JonnIEnglish/RotatingClimbingWall/Development of a rotary climbing wall/chaps-append/chaps-planning-details.tex

\chapter{Planning Details}

\section*{Budget Estimate}
The budget estimate below takes into account rough time and cost estimates. A more refined budget analysis will be implemented later.
Basic calculations are shown below estimating construction costs based on the retail prices of the current market competitor "Treadwall" which is priced at roughly R100 000.\\
Estimating a 3 x development cost multiplier and a 2 x material profit margin: 

\noindent
\(Total = R100,000 / (3 * 2) = R 16,666\)\\

\begin{figure}[h]
    \centering
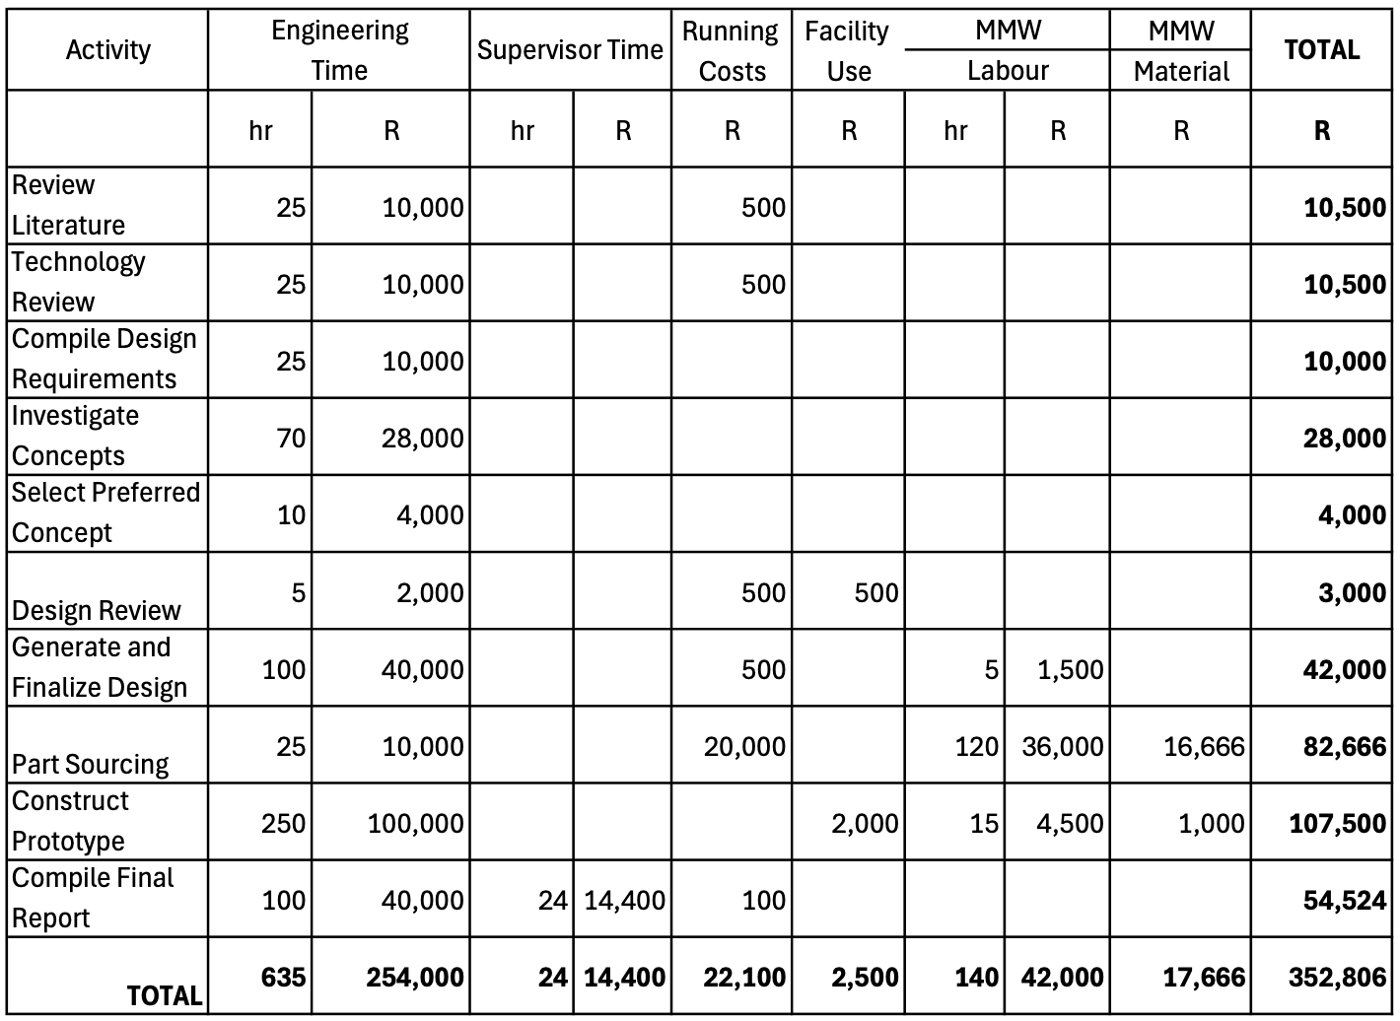
[picture p19: Development of a rotary climbing wall/chaps-append/budget.png]
    
    \caption{Estimated Project Budget}
    \label{fig:budget}
\end{figure}
\newpage

\section*{Gantt Chart}
The gant chart below outlines each planned activity and its estimated start and end date. 
\begin{figure}[htbp]
    \centering
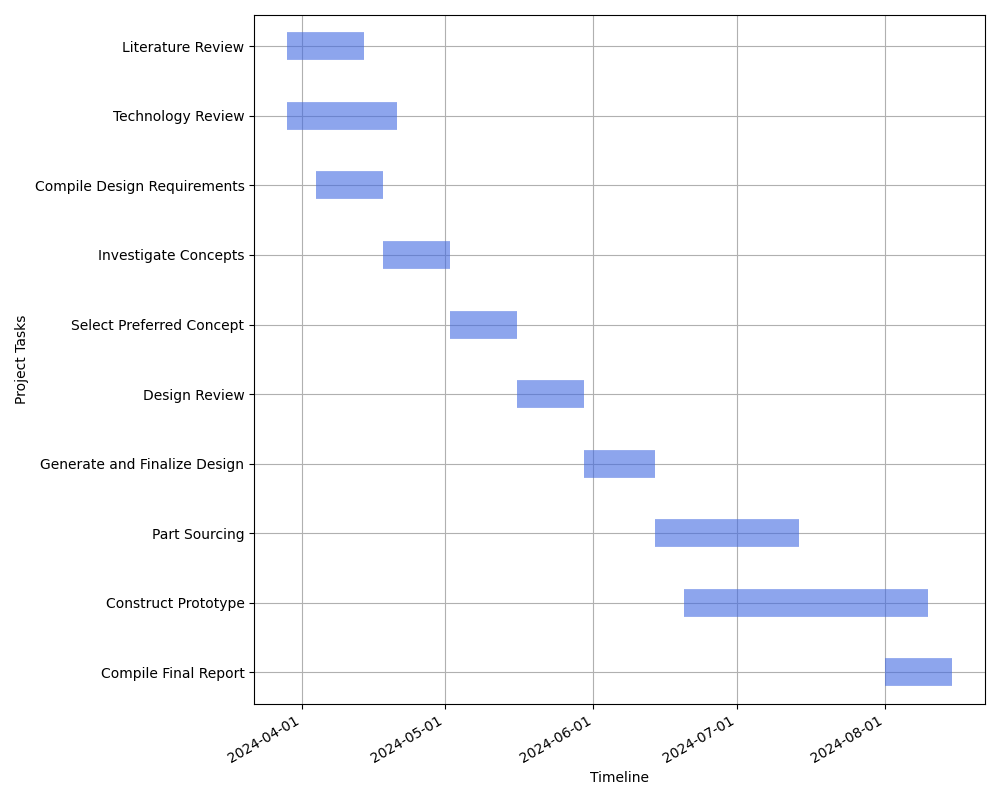
[picture p20: Development of a rotary climbing wall/chaps-append/gantt.png]
    
    \setlength{\leftskip}{-80pt} % Adjust left padding
    \caption{Gantt Chart for Rotary Climbing Wall Prototype}
    \label{fig:gantt}
\end{figure}
