JonnIEnglish/RotatingClimbingWall/Development of a rotary climbing wall/chaps-front/chap-symbols.tex

\chapter{List of symbols}
% Use stb-nomenclature + siunitx

\begin{Nomencl}[1cm]
\NomGroup{Constants}%-----------------------------------------------
    \item[$L_0 = $] \qty{300}{mm}

\NomGroup{Variables}%-----------------------------------------------
    \item[$\mathit{Re}_\mathrm{\,D}$]
                       \UnitLine{Reynolds number (diameter)}{~}
    \item[$x$]         \UnitLine{Coordinate                }{m}
    \item[$\ddot{x}$]  \UnitLine{Acceleration              }{m/s^2}\\
    
    \item[$\theta$]    \UnitLine{Rotation angle            }{rad}
    \item[$\tau$]      \UnitLine{Moment                    }{N.m}

\NomGroup{Vectors and Tensors}%-------------------------------------
    \item[$\overrightarrow{\bm{v}}$] Physical vector, see equation ...

\NomGroup{Subscripts}%----------------------------------------------
    \item[$\mathrm{a}$] Adiabatic
    \item[$a$]          Coordinate

\end{Nomencl}

\begin{Nomencl}[1cm]
\NomGroup{Abreviations}%-----------------------------------------------
    \item[DEM] Discrete Element Method
    \item[FEA] Finite Element Analysis

\end{Nomencl}
