JonnIEnglish/RotatingClimbingWall/Development of a rotary climbing wall/template-stb-report-eng.pdf

# Title

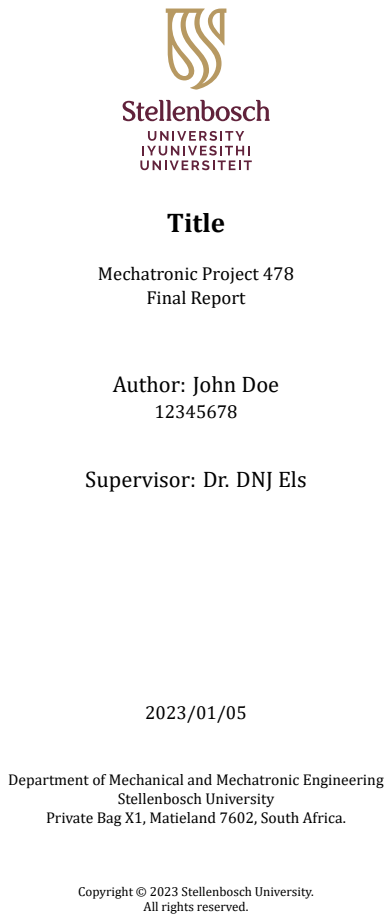
[picture p29: page 1]
Mechatronic Project 478 Final Report; Stellenbosch University

Author: John Doe

Supervisor: Dr. DNJ Els

Department of Mechanical and Mechatronic Engineering

Private Bag X1, Matieland 7602, South Africa.

Copyright © 2023 Stellenbosch University.

All rights reserved.

# Plagiarism declaration

I have read and understand the Stellenbosch University Policy on Plagiarism and the deinitions of plagiarism and self‑plagiarism contained in the Policy [Plagiarism: The use of the ideas or material of others without acknowledge‑ ment, or the re‑use of one’s own previously evaluated or published material without acknowledgement or indication thereof (self‑plagiarism or text‑recyc‑ ling)].
I also understand that direct translations are plagiarism, unless accompa‑ nied by an appropriate acknowledgement of the source. I also know that ver‑ batim copy that has not been explicitly indicated as such, is plagiarism.
I know that plagiarism is a punishable offence and may be referred to the University’s Central Disciplinary Committee (CDC) who has the authority to ex‑ pel me for such an offence.
I know that plagiarism is harmful for the academic environment and that it has a negative impact on any profession.
Accordingly all quotations and contributions from any source whatsoever (including the internet) have been cited fully (acknowledged); further, all ver‑ batim copies have been expressly indicated as such (e.g. through quotation marks) and the sources are cited fully.
I declare that, except where a source has been cited, the work contained in this assignment is my own work and that I have not previously (in its entirety or in part) submitted it for grading in this module/assignment or another mod‑ ule/assignment. I declare that have not allowed, and will not allow, anyone to use my work (in paper, graphics, electronic, verbal or any other format) with the intention of passing it off as his/her own work.
I know that a mark of zero may be awarded to assignments with plagiarism and also that no opportunity be given to submit an improved assignment.
Signature: | |
Name: | | | Student no: |
Date: | |

ii

# Executive summary

Title of Project

Objectives

What is current practice and what are its limitations? ...

What is new in this project? ...

If the project is successful, how will it make a difference?

What are the risks to the project being a success? Why is it expected to be successful?

What contributions have/will other students made/make?

Which aspects of the project will carry on after completion and why? ...

What arrangements have been/will be made to expedite continuation? ...

iii

# Acknowledgements

iv

# Table of contents

List of igures | vi
List of tables | vii
List of symbols | viii
1 Introduction | 1
2 Literature review | 2
3 Content chapter | 3
4 Conclusions | 5
A Mathematical proofs | 6
B Experimental results | 7
List of references | 8

v

# List of igures

3.1 Water plants | 4

vi

# List of tables

3.1 Standard ISO paper sizes | 4

vii

# List of symbols

Constants
L0 = 300 mm

Variables
Re D | Reynolds number (diameter) | | [ ]
x | Coordinate | | [ m ]
̈x | Acceleration | | [ m/s²
]
θ | Rotation angle | | [ rad ]
τ | Moment | | [ N·m ]

Vectors and Tensors
⃗v Physical vector, see equation ...

Subscripts
a | Adiabatic
a | Coordinate

Abreviations
DEM | Discrete Element Method
FEA | Finite Element Analysis

viii

# Chapter 1

# Introduction

## 1.1 Background

Starting from the big picture, gradually narrow focus down to this project and where this report its in.

## 1.2 Objectives

The objectives of the project (in some cases the objectives of the report). If necessary describe limitations to the scope.

## 1.3 Motivation

Why this speciic project/report is worthwhile.

1

# Chapter 2

# Literature review

## 2.1 Discrete element method

The Discrete Element Method (DEM) analysis (Cundall and Strack, 1979) uses spherical objects. Lin and Ng (1997) developed a DEM model for ellipsoids.

2

# Chapter 3

# Content chapter

Unless the chapter heading already makes it clear, an introductory paragraph that explains how this chapter contributes to the objectives of the report/project.

## 3.1 Heading level 2

### 3.1.1 Heading level 3

### 3.1.1.1 Deepest heading, only if you cannot do without it

Equations: An equation must read like part of the text. The solution of the quadratic equation ax² + bx + c = 0 given by the following expression (note the full stop after the equation to indicate the end of the sentence):

x =

−b ± √b
2 − 4ac
2b | . | (3.1)

In other cases the equation is in the middle of the sentence. Then the paragraph following the equation should start with a small letter. Euler’s identity is

e

iπ + 1 = 0, | | (3.2)

where e is Euler’s number, the base of natural logarithms.
The amsmath has a wealth of structure and information on formatting of mathematical equations.

3

4 | CHAPTER 3. CONTENT CHAPTER

Symbols and numbers: Symbols that represent values of properties should be printed in italics, but SI units and names of functions (e.g. sin, cos and tan) must not be printed in italics. There must be a small hard space between a number and its unit, e.g. 120 km. Use the siunitx package to typeset numbers, angles and quantities with units:

\num{1.23e3} | → 1.23×10³
\ang{30} | → 30°
\qty{20}{N.m} → 20 N·m

Figures and tables: The graphicx package can import PDF, PNG and JPG graphic iles.

Table 3.1: Standard ISO paper sizes

Paper | | Sizes
| W | H
| [mm] | [mm]
A0 | 841 | 1189
A1 | 594 | 841
A2 | 420 | 594
A3 | 297 | 420
A4 | 210 | 297
A5 | 148 | 210


Figure 3.1: Water plants

# Chapter 4

# Conclusions

5

# Appendix A

# Mathematical proofs

## A.1 Euler’s equation

Euler’s equation gives the relationship between the trigonometric functions and the complex exponential function.

e

iθ = cos θ + i sin θ | (A.1)

Inserting θ = π in (A.1) results in Euler’s identity

e

iπ + 1 = 0 | (A.2)

## A.2 Navier Stokes equation

The Navier–Stokes equations mathematically express momentum balance and conservation of mass for Newtonian luids. Navier‑Stokes equations using ten‑ sor notation:

∂ρ
∂t +

∂
∂xj

ρuj

= 0 | (A.3a)

∂
∂t

(ρui

) +

∂
∂xj

ρuiuj + pδij − τji = 0, i = 1, 2, 3 (A.3b)

∂
∂t

(ρe0

) +

∂
∂xj
ρuje0 + ujp + qj − uiτij = 0 | (A.3c)

6

# Appendix B

# Experimental results

7

# List of references

Cundall, P.A. and Strack, O.D.L. (1979). A discrete numerical model for granular assem‑ blies. Géotechnique, vol. 29, no. 1, pp. 47–65.

Lin, X. and Ng, T.T. (1997). A three‑dimensional discrete element model using arrays of ellipsoids. Géotechnique, vol. 47, no. 2, pp. 319–329.

8
