JonnIEnglish/RotatingClimbingWall/Development of a rotary climbing wall/figs/DesignMethodologyFlow.pdf

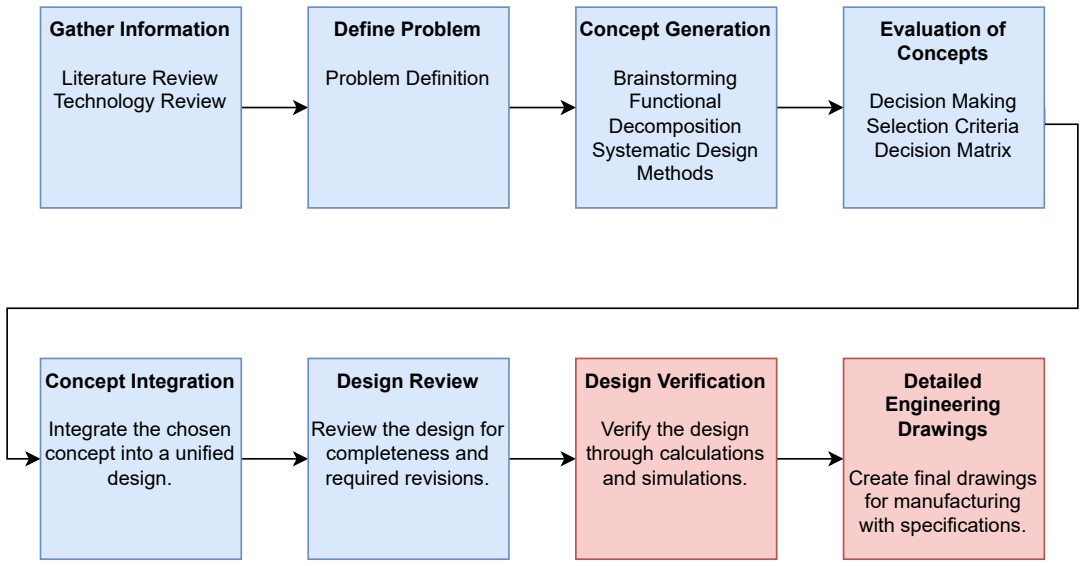
[picture p30: figure]
Gather Information; Literature Review Technology Review; Concept Generation; Brainstorming Functional Decomposition Systematic Design Methods; Evaluation of Concepts; Decision Making Selection Criteria Decision Matrix; Concept Integration; Integrate the chosen concept into a unified design.; Design Review; Review the design for completeness and required revisions.; Design Verification; Verify the design through calculations and simulations.; Detailed Engineering Drawings; Create final drawings for manufacturing with specifications.; Define Problem; Problem Definition

Conceptual
Design

Key

Detail Design
