JonnIEnglish/RotatingClimbingWall/Development of a rotary climbing wall/chaps-append/Budget_table.png

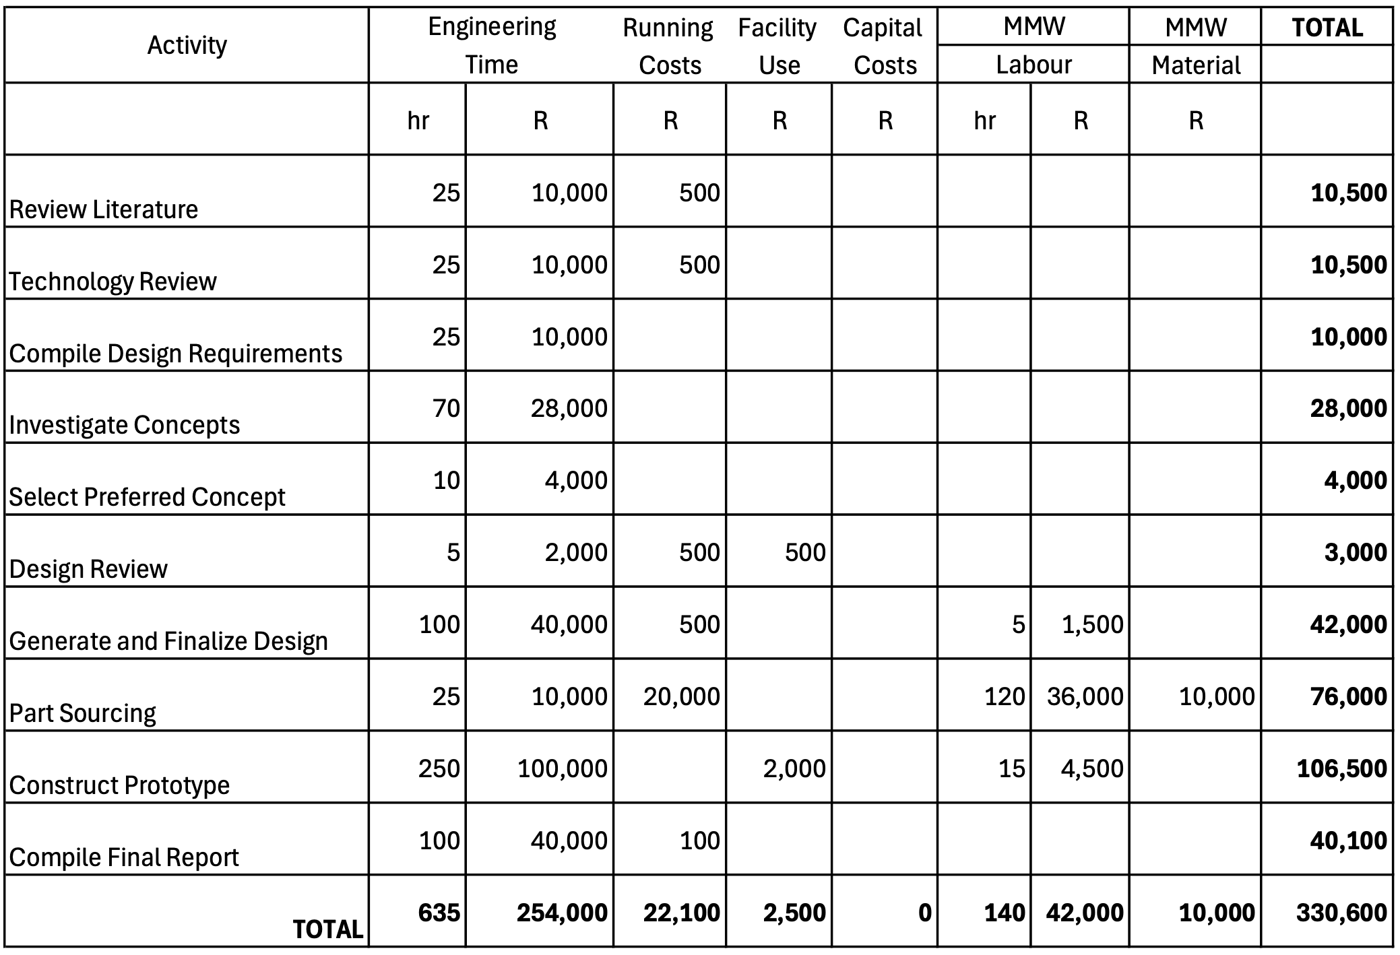
Development of a rotary climbing wall/chaps-append/Budget_table.png
