JonnIEnglish/RotatingClimbingWall/Development of a rotary climbing wall/chaps-append/calcs/tilt_torqe_calcs.png

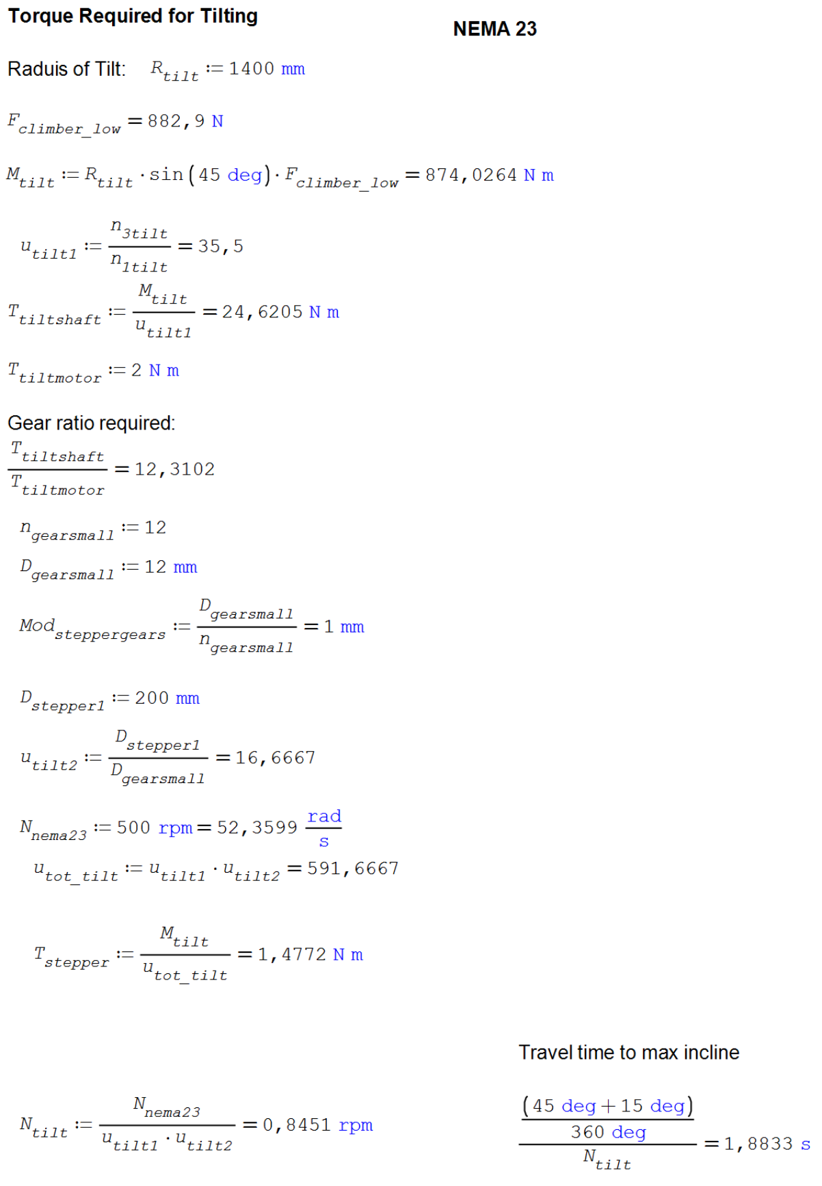
Development of a rotary climbing wall/chaps-append/calcs/tilt_torqe_calcs.png
