JonnIEnglish/RotatingClimbingWall/Development of a rotary climbing wall/chaps-append/macsteel-prices.png

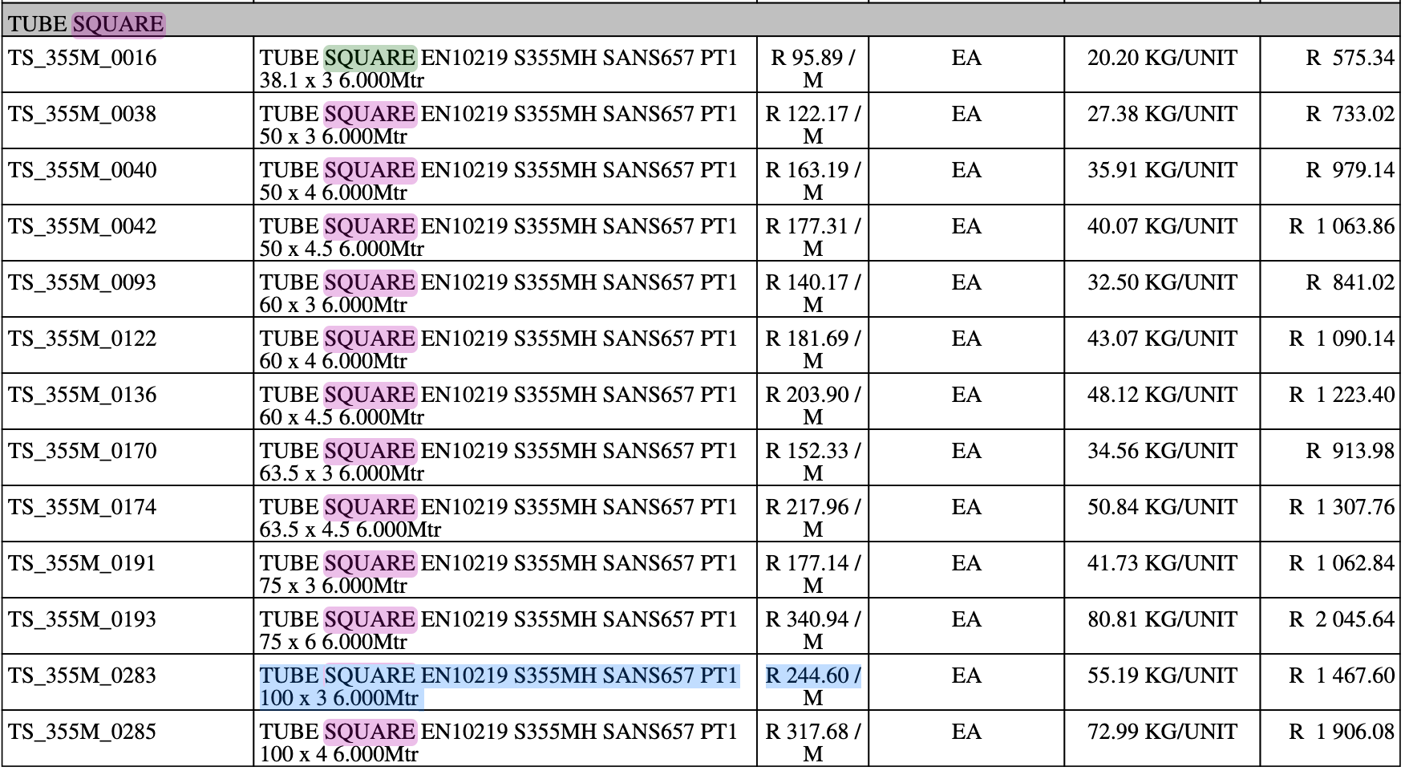
Development of a rotary climbing wall/chaps-append/macsteel-prices.png
