JonnIEnglish/RotatingClimbingWall/Development of a rotary climbing wall/figs/FEM/TiltingShaft.png

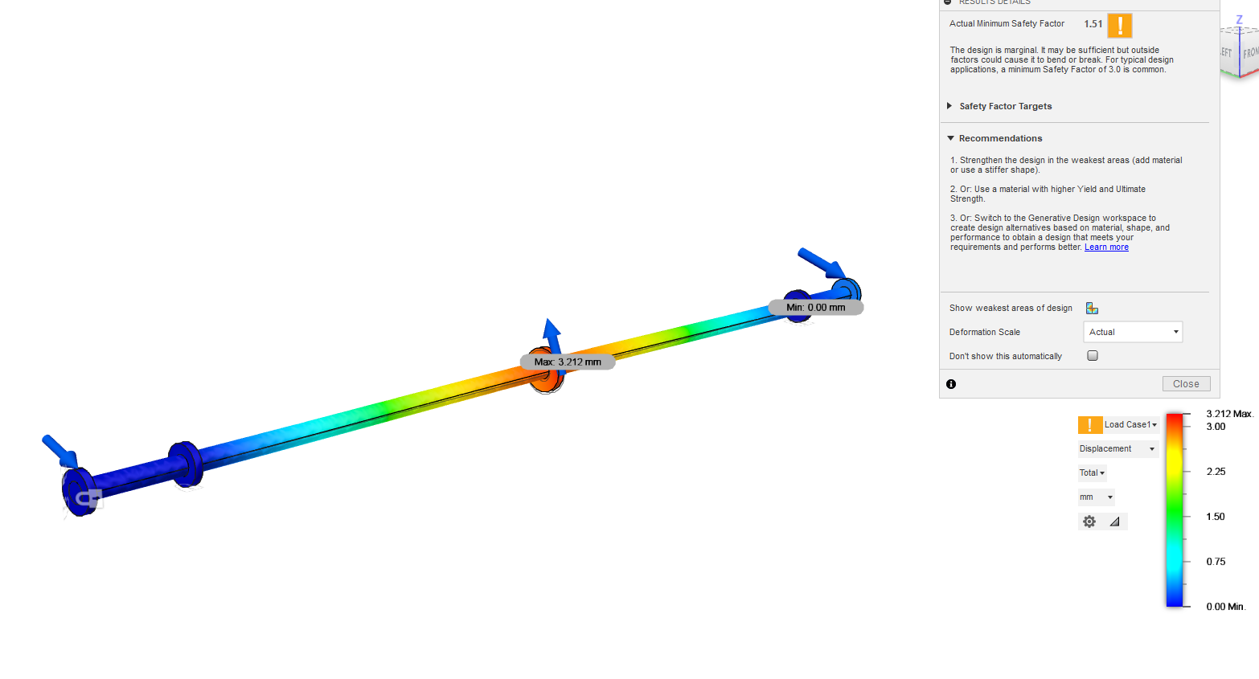
Development of a rotary climbing wall/figs/FEM/TiltingShaft.png
