JonnIEnglish/RotatingClimbingWall/Development of a rotary climbing wall/figs/final_design/FEMBracket0.png

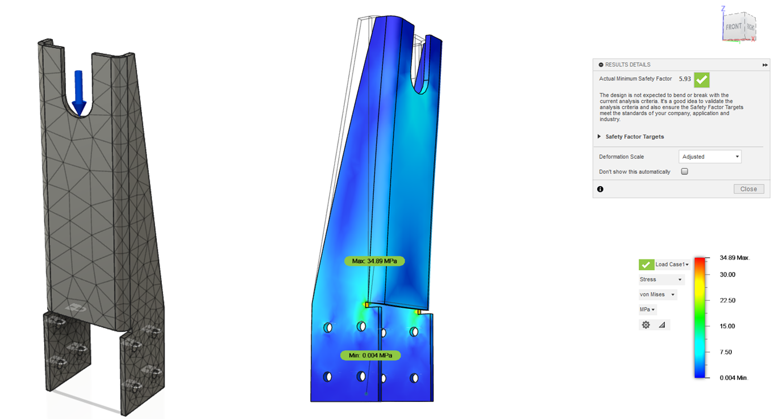
Development of a rotary climbing wall/figs/final_design/FEMBracket0.png
