JonnIEnglish/RotatingClimbingWall/Development of a rotary climbing wall/figs/training_table.png

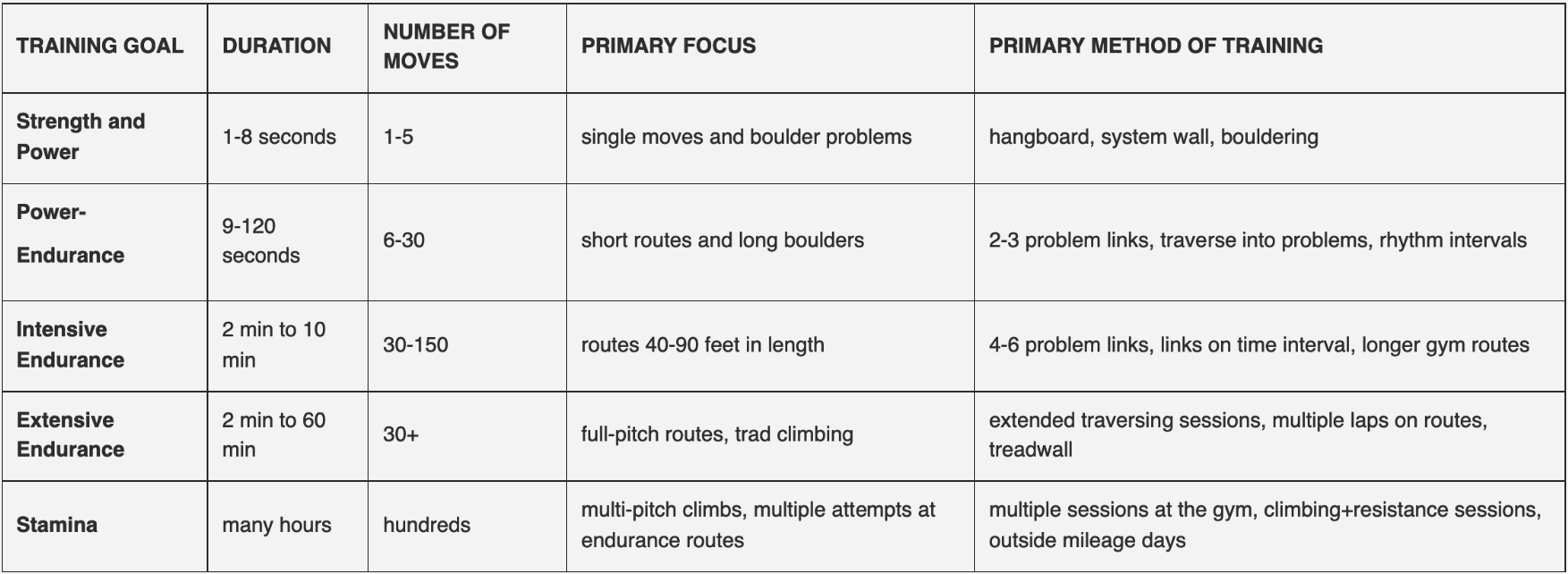
Development of a rotary climbing wall/figs/training_table.png
