JonnIEnglish/RotatingClimbingWall/Development of a rotary climbing wall/figs/treadwall.jpg

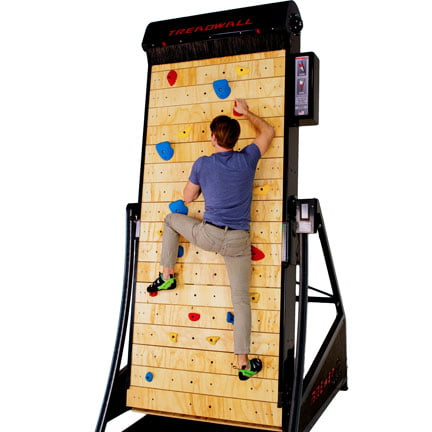
Development of a rotary climbing wall/figs/treadwall.jpg
