JonnIEnglish/RotatingClimbingWall/Development of a rotary climbing wall/figs/treadwall_kore4_CAD.png

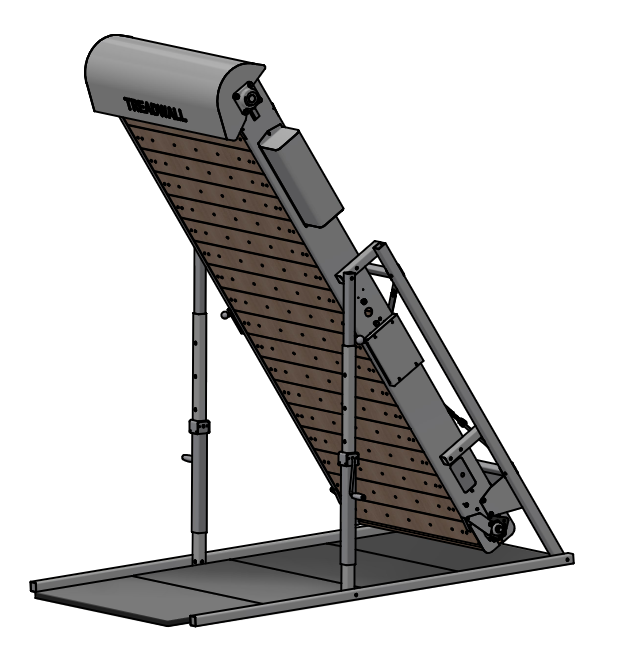
Development of a rotary climbing wall/figs/treadwall_kore4_CAD.png
