JonnIEnglish/RotatingClimbingWall/Development of a rotary climbing wall/figs/volume_intensity.png

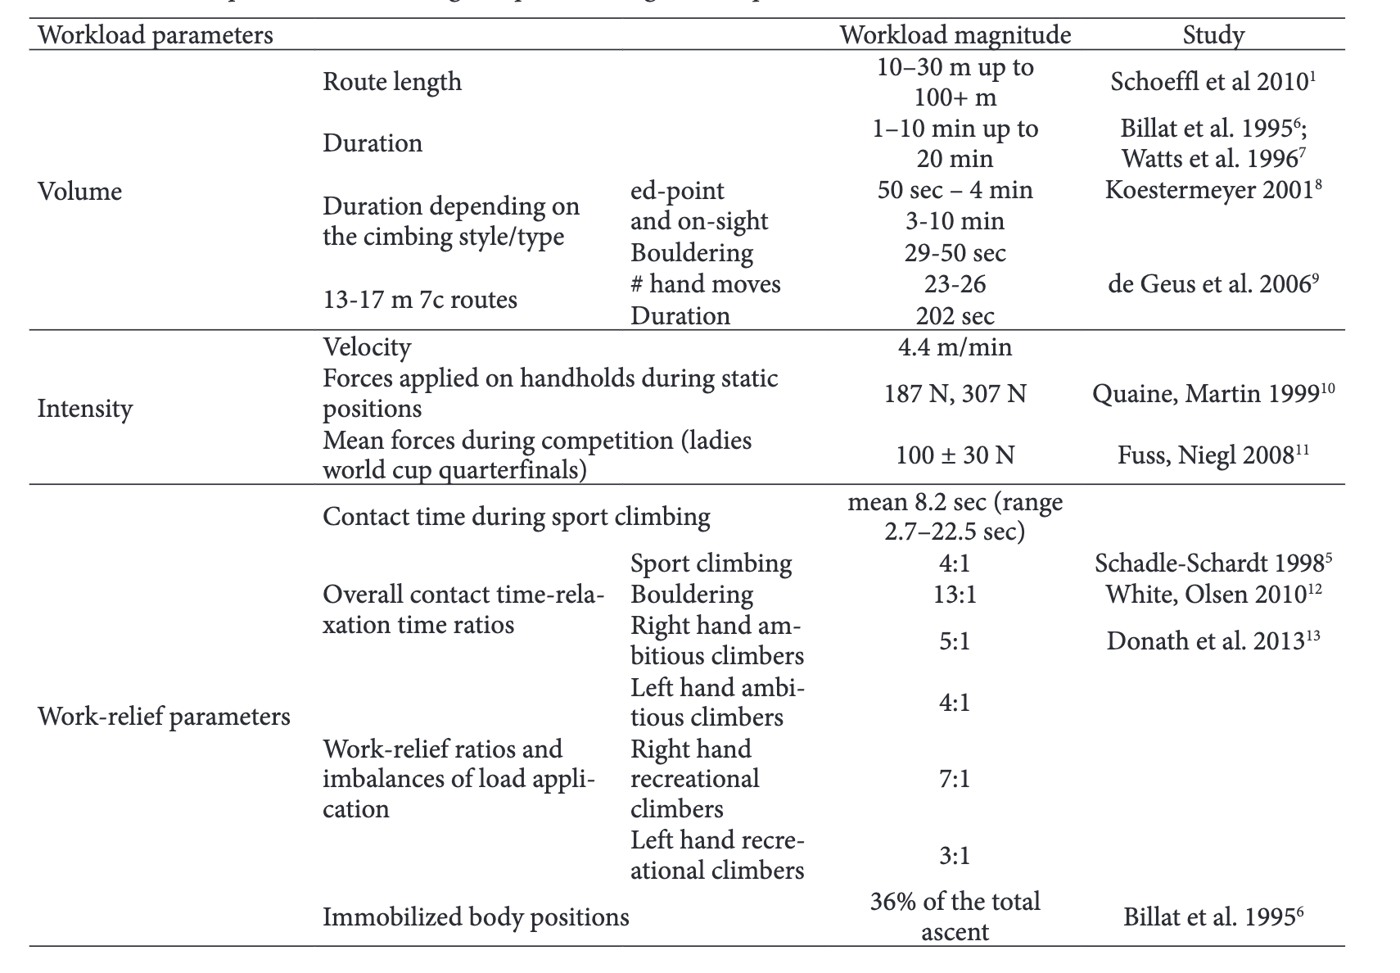
Development of a rotary climbing wall/figs/volume_intensity.png
