JonnIEnglish/RotatingClimbingWall/Development of a rotary climbing wall/figs/testing/speed_test.png

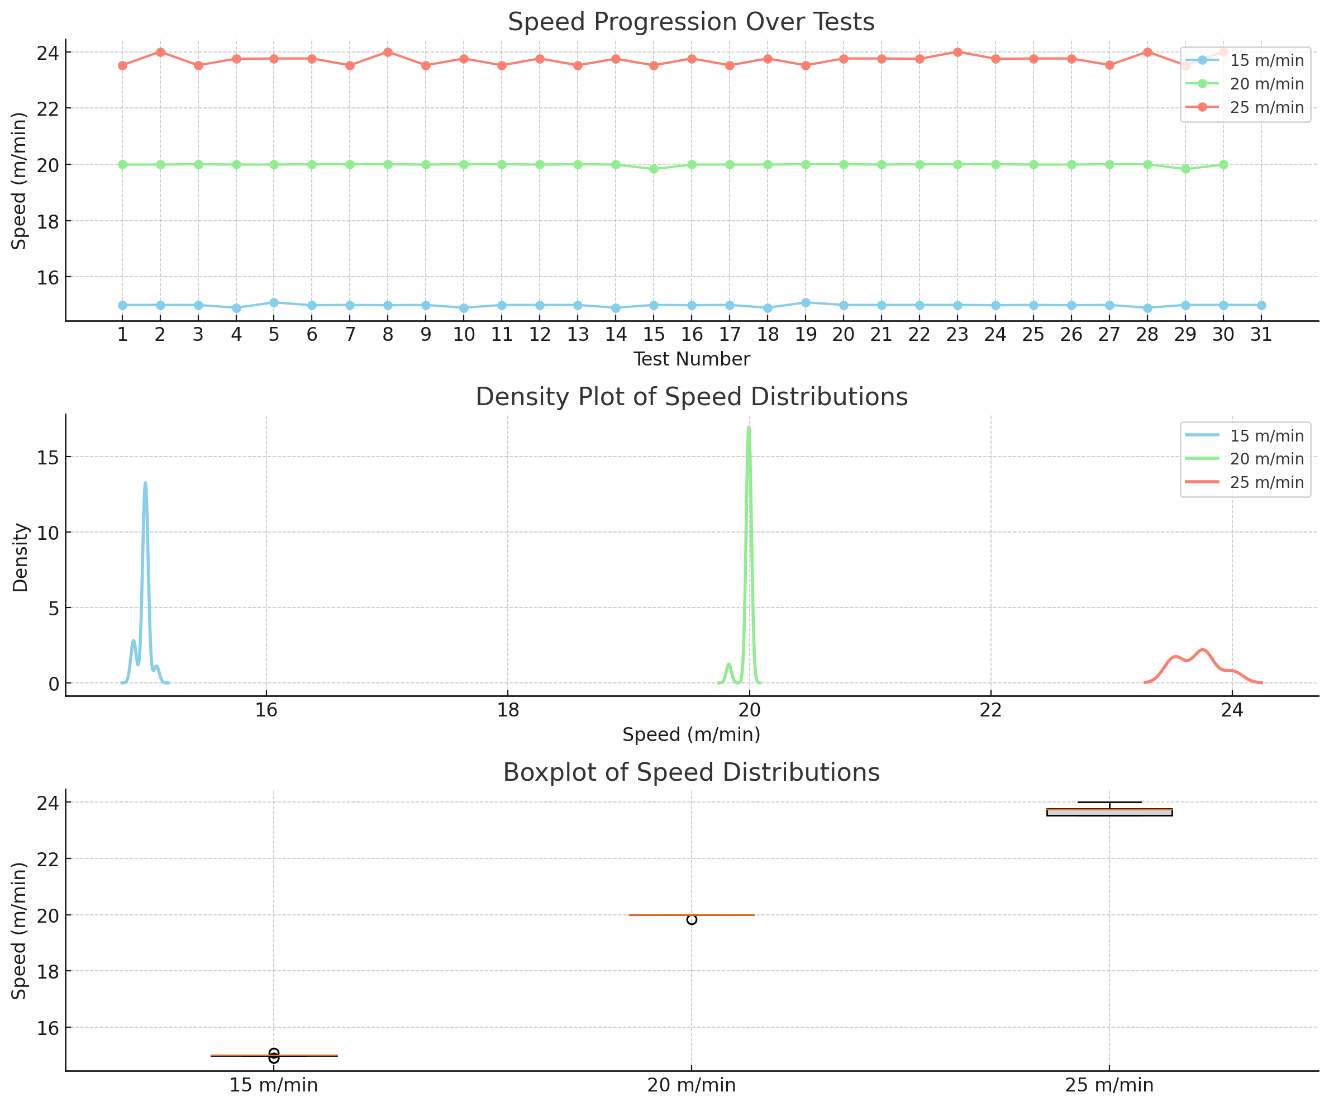
Development of a rotary climbing wall/figs/testing/speed_test.png
