JonnIEnglish/RotatingClimbingWall/Development of a rotary climbing wall/figs/final_design/Incline_subsystem_CAD-1.pdf

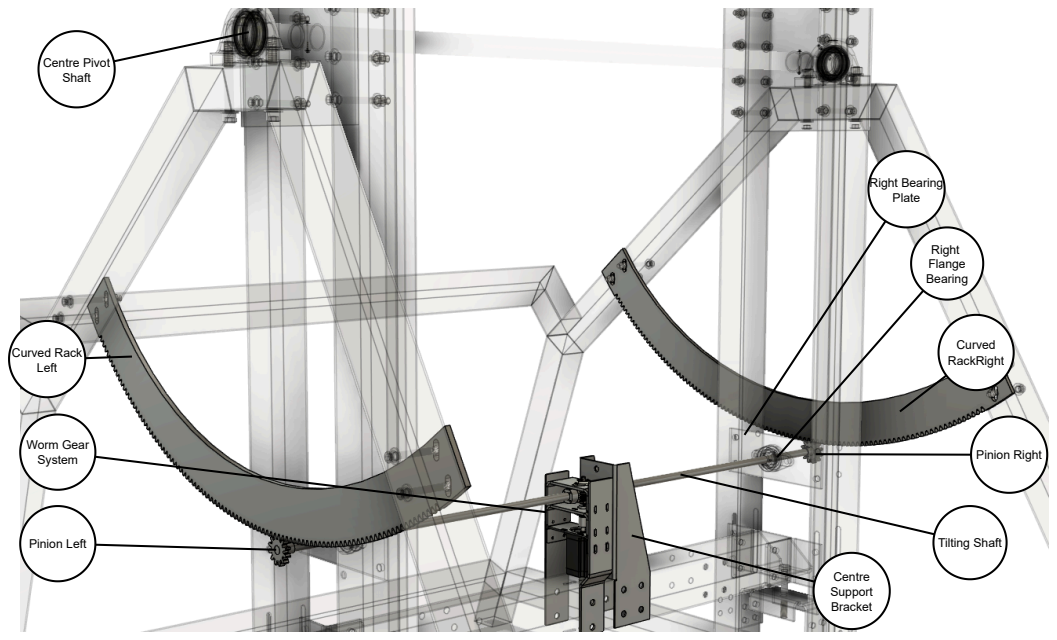
[picture p48: page 1]
Curved; Pinion Left; Tilting Shaft; Pinion Right; Centre Support Bracket; Right Bearing Plate; Right Flange Bearing; Centre Pivot Shaft; Worm Gear System

RackRight Curved Rack
Left
