JonnIEnglish/RotatingClimbingWall/Development of a rotary climbing wall/figs/final_design/wormgear_assembly_CAD.pdf

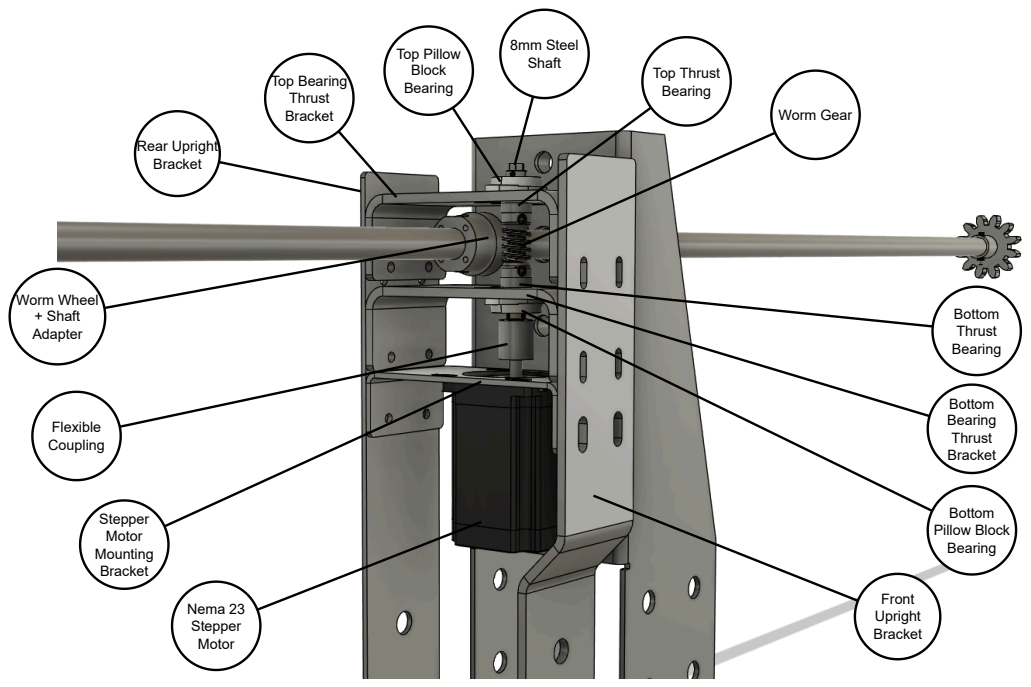
[picture p49: page 1]
Nema 23 Stepper Motor; Stepper Motor Mounting Bracket; Bottom Bearing Thrust Bracket; Top Bearing Thrust Bracket; Top Pillow Block Bearing; Bottom Pillow Block Bearing; Bottom Thrust Bearing; Top Thrust Bearing; Flexible Coupling; Worm Gear; Worm Wheel + Shaft Adapter; 8mm Steel Shaft; Front Upright Bracket; Rear Upright Bracket
