JonnIEnglish/RotatingClimbingWall/Development of a rotary climbing wall/figs/concept_design/Functional_Decomp_Flow.pdf

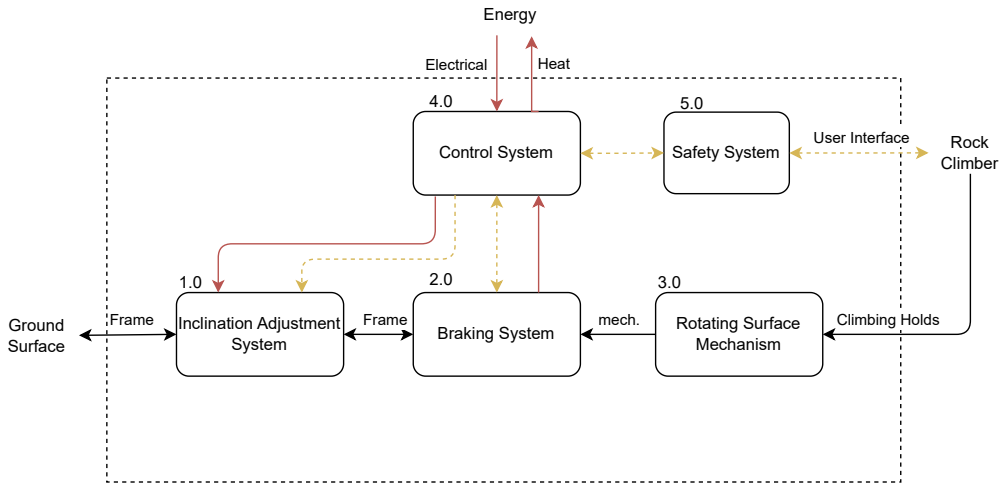
[picture p50: page 1]
Control System; Rotating Surface Mechanism; Frame; Rock Climber; Ground Surface; Electrical; Energy; Braking System; Inclination Adjustment System; mech.; Climbing Holds; Safety System; User Interface; Heat
