JonnIEnglish/RotatingClimbingWall/Development of a rotary climbing wall/figs/concept_design/Handcrank_Concept.pdf

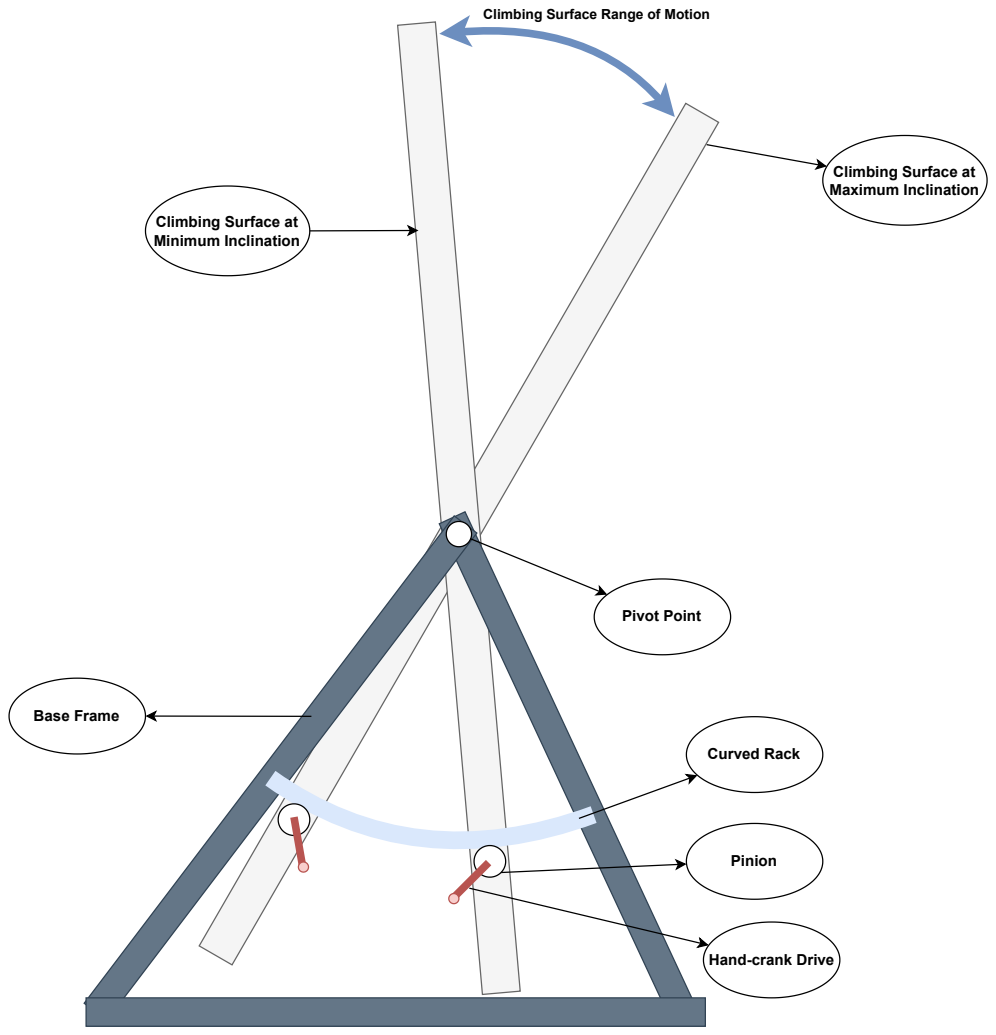
[picture p51: page 1]
Pivot Point; Curved Rack; Pinion; Base Frame

Climbing Surface Range of Motion

Climbing Surface at
Maximum Inclination

Minimum Inclination

Hand-crank Drive
