JonnIEnglish/RotatingClimbingWall/Development of a rotary climbing wall/figs/concept_design/Linear_Actuator_Concept.pdf

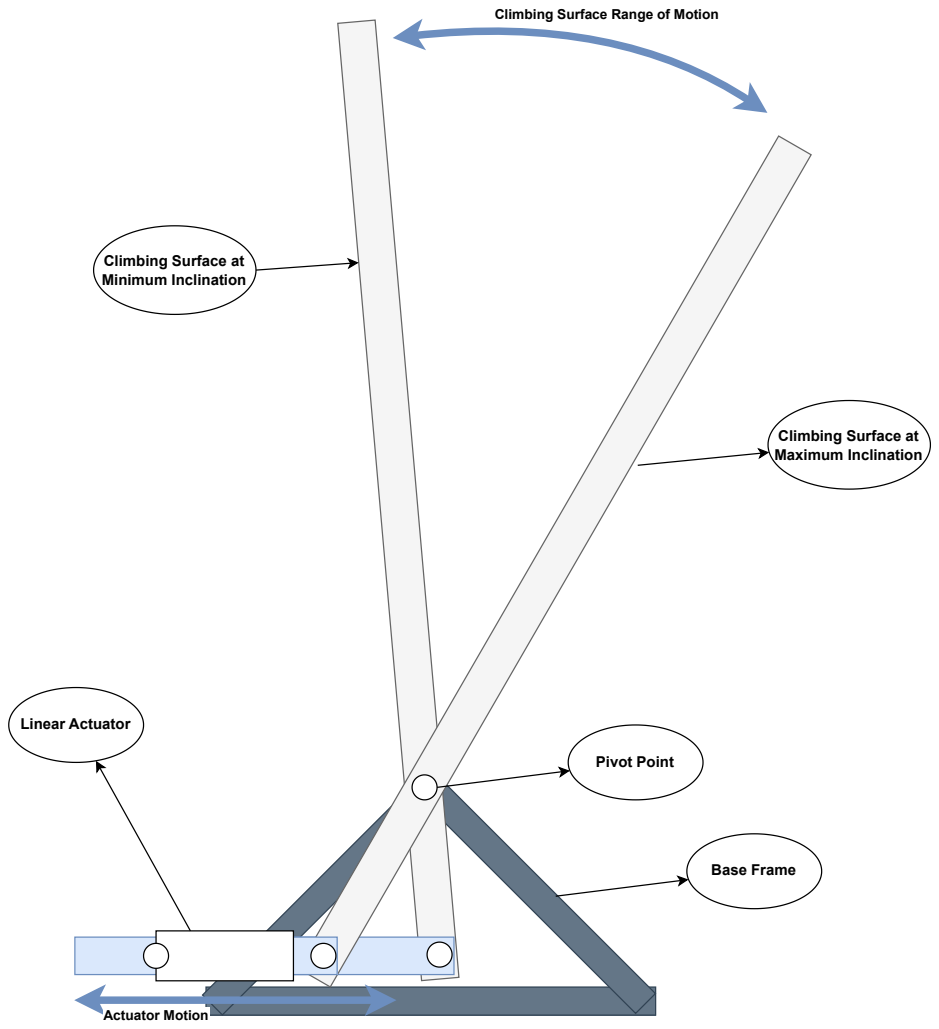
[picture p52: page 1]
Actuator Motion; Linear Actuator; Pivot Point; Base Frame

Climbing Surface Range of Motion

Climbing Surface at
Minimum Inclination

Maximum Inclination
