JonnIEnglish/RotatingClimbingWall/Development of a rotary climbing wall/figs/BaseFrame.pdf

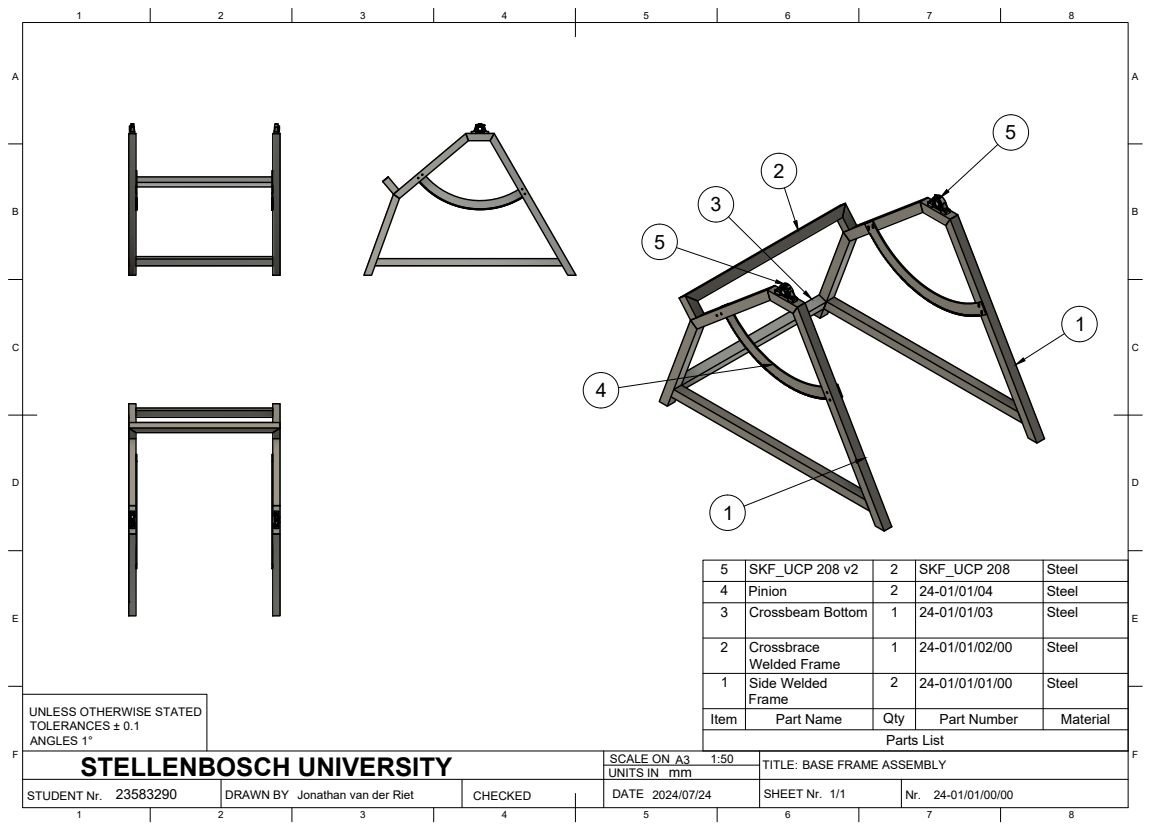
[picture p53: page 1]
F STELLENBOSCH UNIVERSITY; STUDENT Nr.; DRAWN BY; CHECKED; DATE; UNITS IN; SCALE ON; TITLE:; SHEET Nr.; UNLESS OTHERWISE STATED TOLERANCES ± 0.1 ANGLES 1°; Jonathan van der Riet; BASE FRAME ASSEMBLY; Parts List

5 | SKF_UCP 208 v2 | 2 | SKF_UCP 208 | Steel
4 | Pinion | 2 | 24-01/01/04 | Steel
3 | Crossbeam Bottom | 1 | 24-01/01/03 | Steel

2 | Crossbrace Welded Frame | 1 | 24-01/01/02/00 | Steel

1 | Side Welded Frame | 2 | 24-01/01/01/00 | Steel

Item | Part Name | Qty | Part Number | Material
