JonnIEnglish/RotatingClimbingWall/Development of a rotary climbing wall/figs/disciplines_physical.pdf

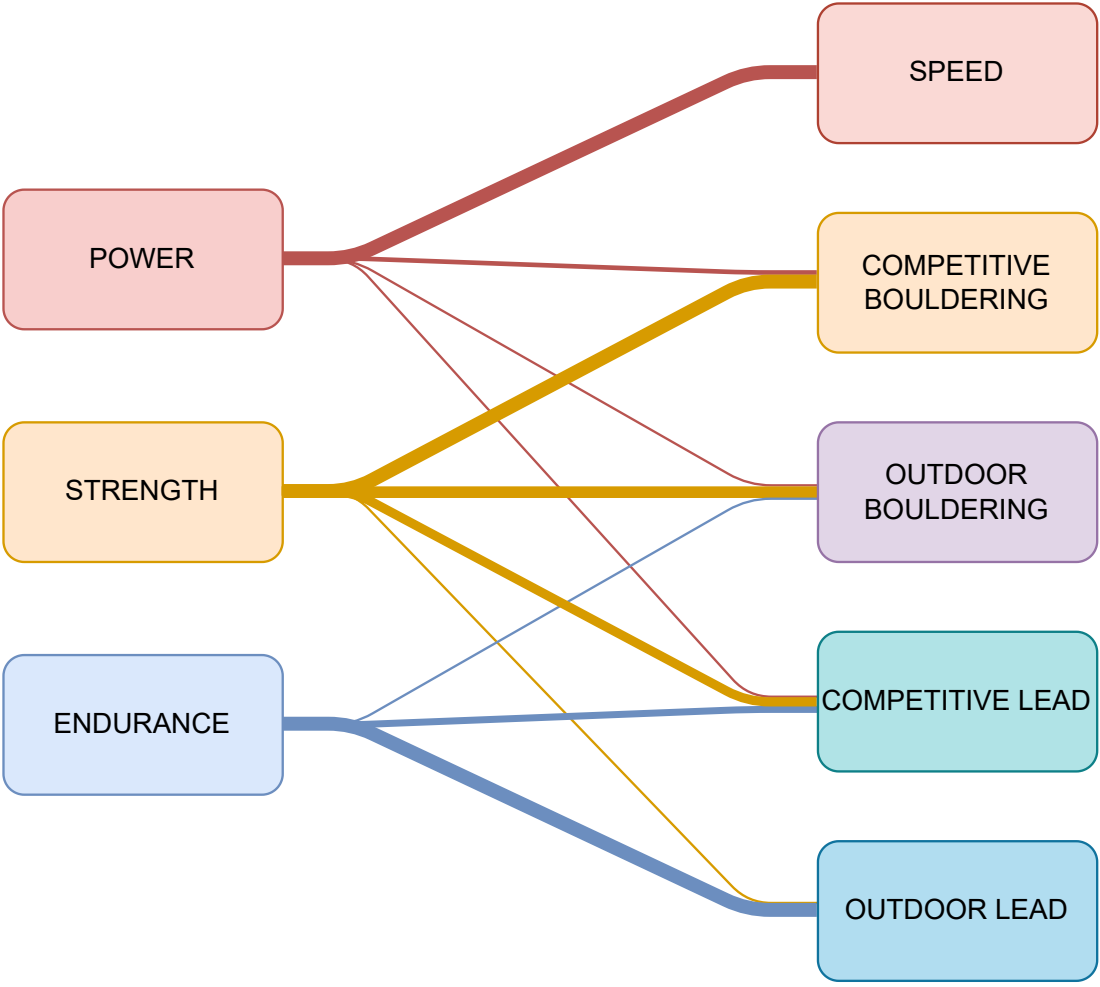
[picture p54: page 1]
POWER; STRENGTH; ENDURANCE; COMPETITIVE BOULDERING; SPEED; COMPETITIVE LEAD; OUTDOOR LEAD; OUTDOOR BOULDERING
