JonnIEnglish/RotatingClimbingWall/Development of a rotary climbing wall/figs/final_design/BrakingSyst.pdf

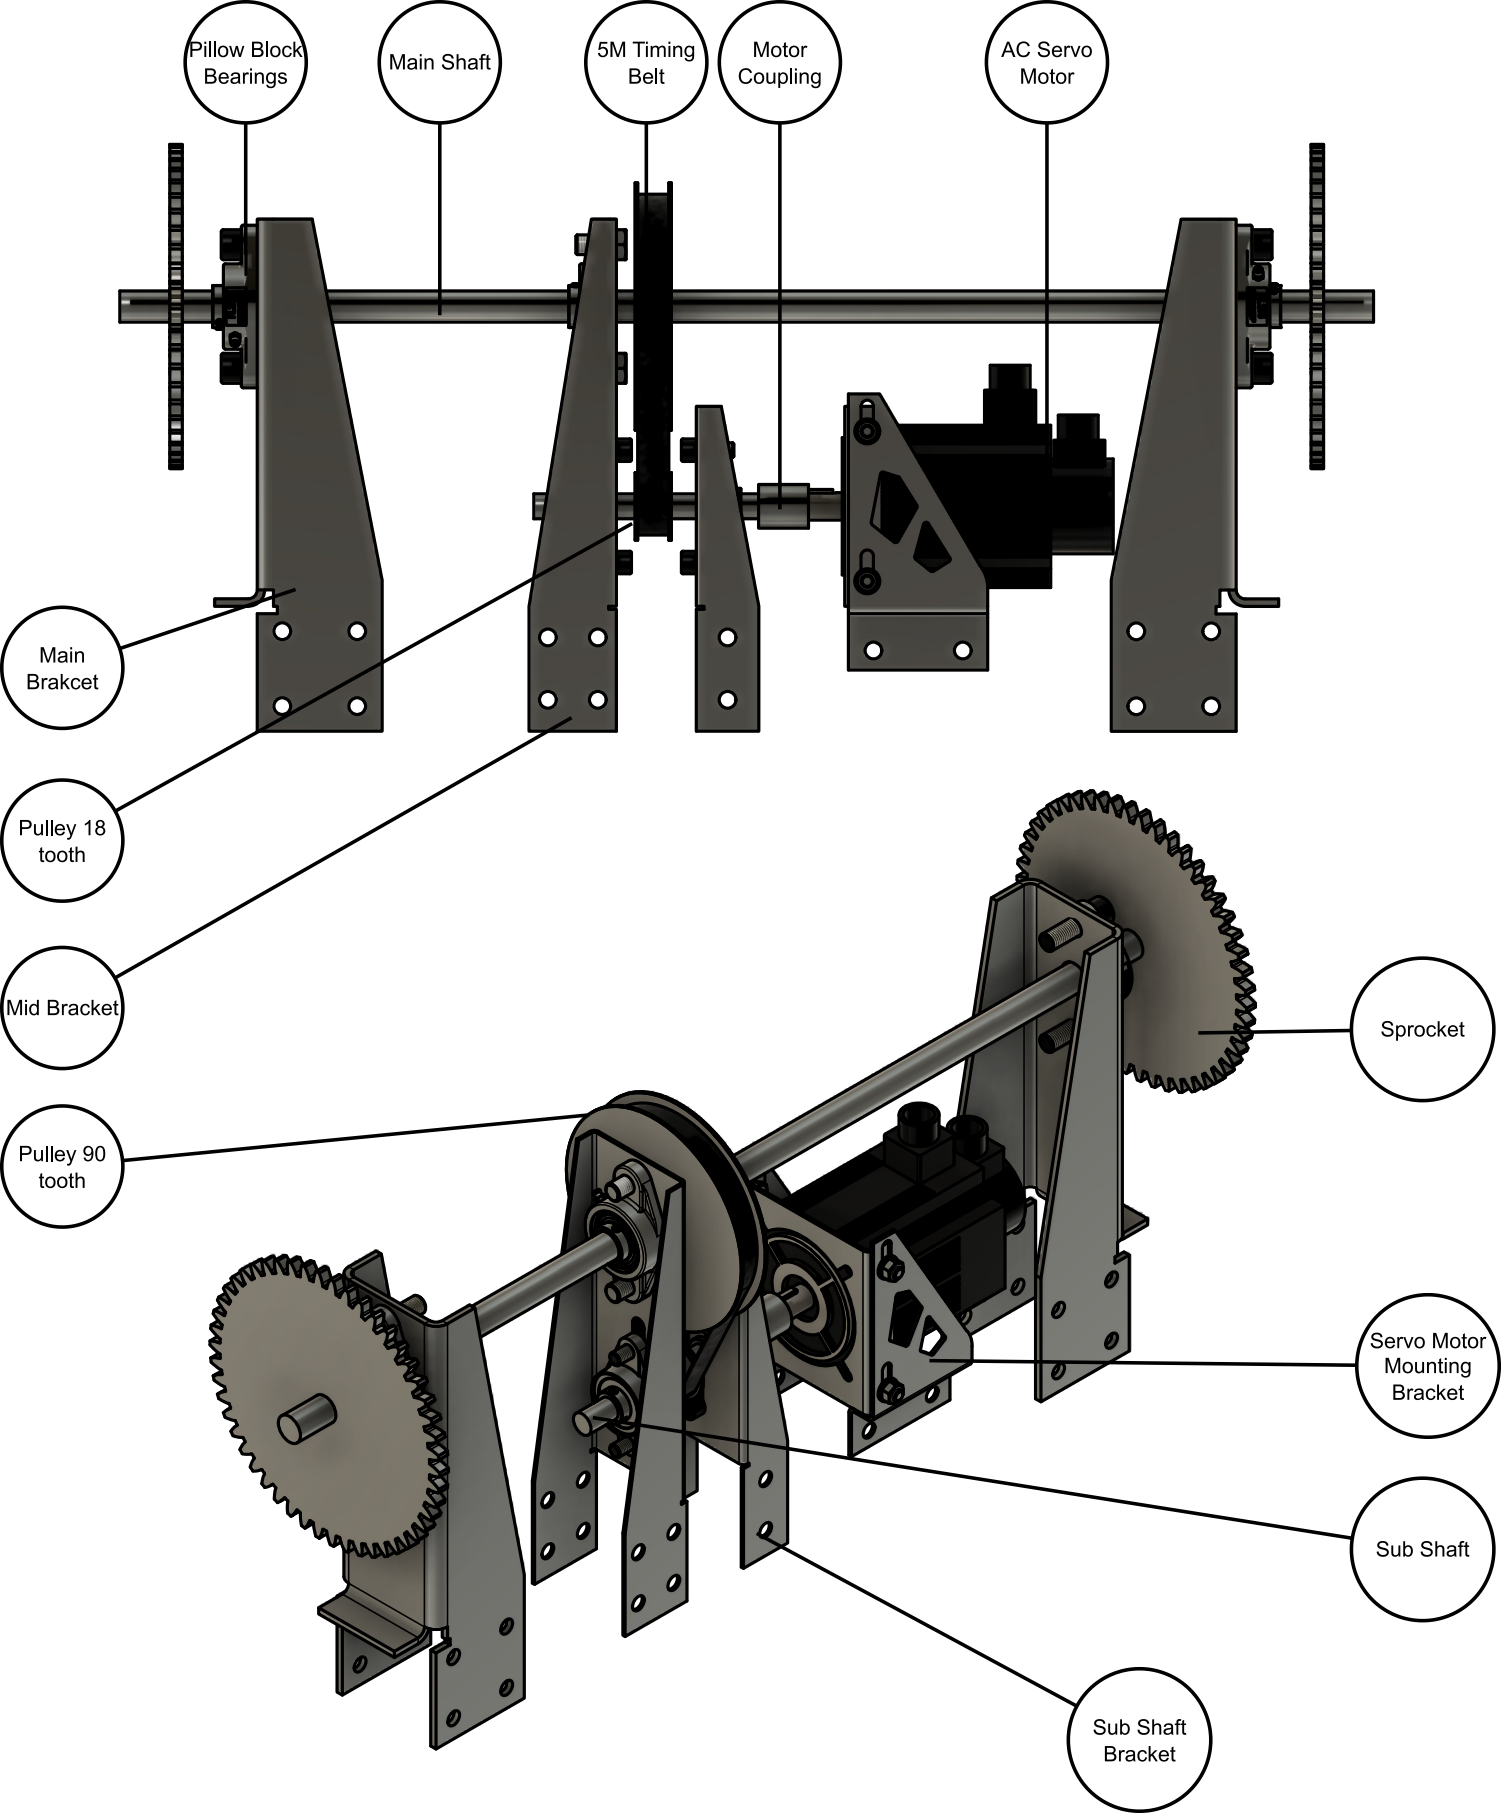
[picture p55: page 1]
