JonnIEnglish/RotatingClimbingWall/Development of a rotary climbing wall/figs/final_design/Main_Assembly_CAD.pdf

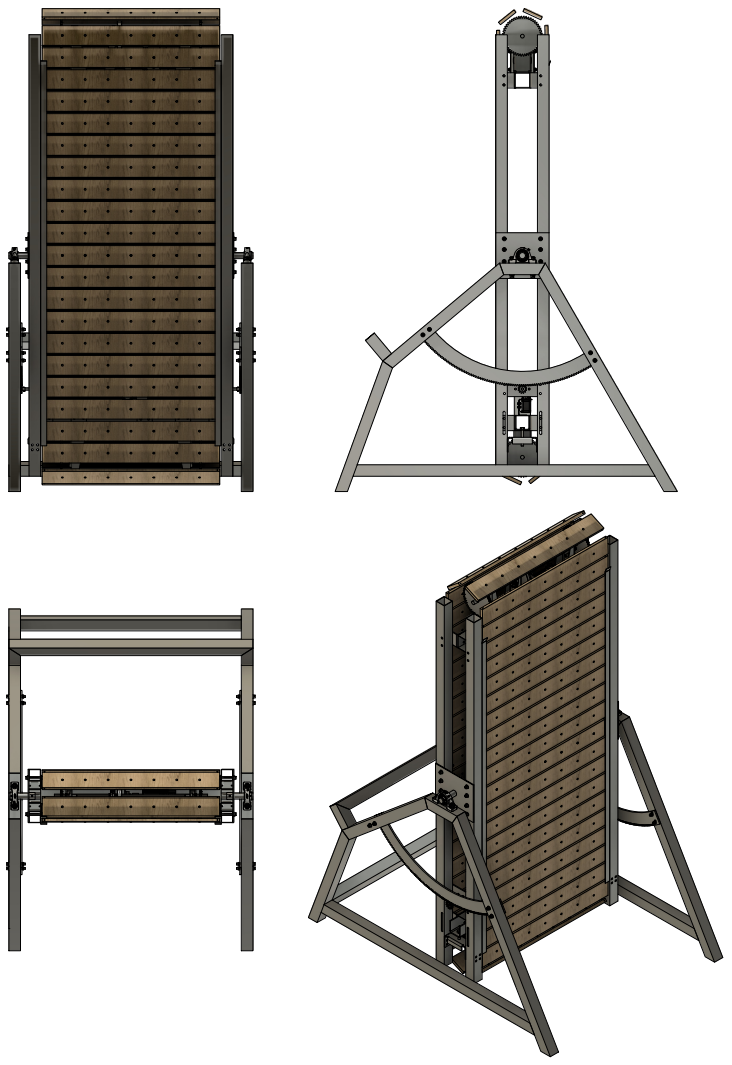
[picture p56: page 1]
8 BCDEF; ABCDEF
