JonnIEnglish/RotatingClimbingWall/Development of a rotary climbing wall/figs/disciplines_physical_old.pdf

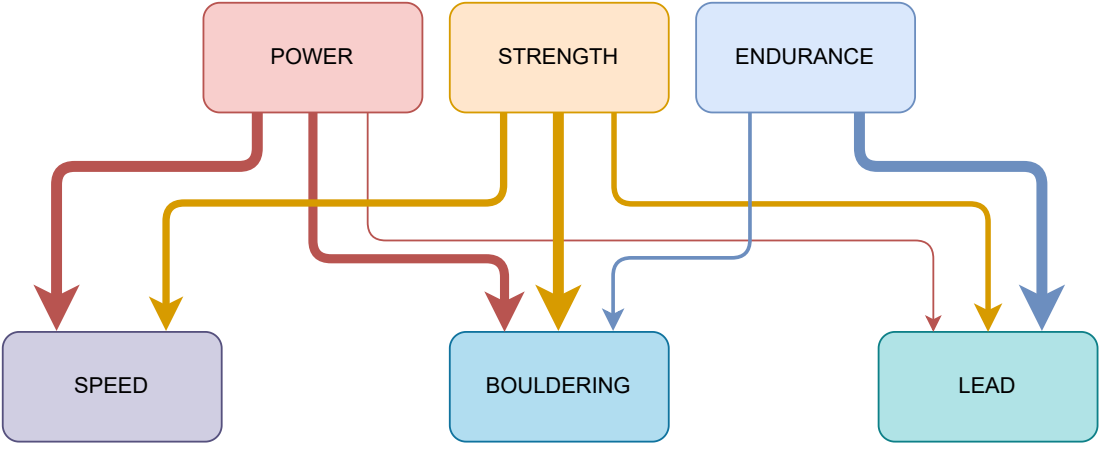
[picture p57: page 1]
SPEED; BOULDERING; LEAD; POWER; STRENGTH; ENDURANCE
