JonnIEnglish/RotatingClimbingWall/(commit log)

2024-09-11 Stepper Motor working with 2 limit switches.
    Bugs still to be ironed out
    [Tilting.ino]
2024-09-11 Fixed Limit Switch logic and accounted for anoms
    [Tilting.ino]
2024-09-12 Manual Controlled Calibration
